jiangwu7/foresight/docs/competition/phase2_device/live_capture_galaxy_s23u.png

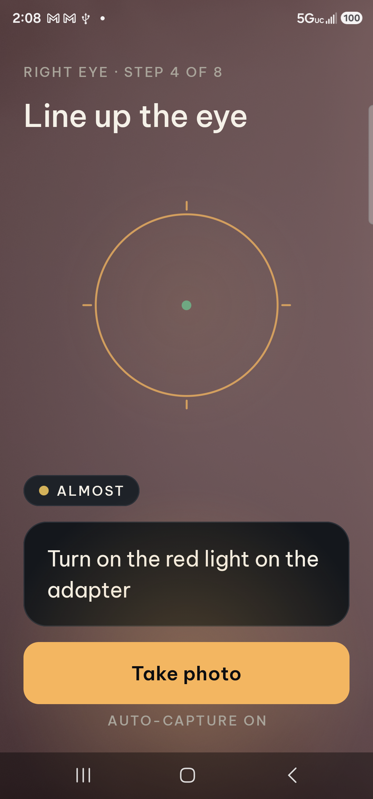
docs/competition/phase2_device/live_capture_galaxy_s23u.png
