jiangwu7/foresight/hardware/safety_calc.xlsx

Sheet: inputs
Input | Value | Status
f_eye_mm | 17 | standard
field_deg | 45 | standard
pupil_mm_worst | 8 | standard
T_polarizer | 0.38 | ASSUMED
R_beamsplitter | 0.5 | ASSUMED
T_lens | 0.92 | ASSUMED
f_collect | 0.1 | ASSUMED
f_pupil | 1 | standard
alignment_red.part | ASSUMED: 5 mm 660 nm AlGaInP LED, e.g. Kingbright WP7113SRC/J-type | ASSUMED
alignment_red.I_mA | 5 | ASSUMED
alignment_red.radiant_power_mW_at_20mA | 4 | ASSUMED
alignment_red.A_weight | 0.001 | ISO table
alignment_red.exposure_s | 120 | ASSUMED
capture_white.part | ASSUMED: 5 mm warm-white (2700-3000 K, CRI>=90) LED | ASSUMED
capture_white.I_mA | 20 | ASSUMED
capture_white.radiant_power_mW_at_20mA | 15 | ASSUMED
capture_white.A_weight | 0.2 | ASSUMED
capture_white.exposure_s | 0.05 | ASSUMED
capture_white.flashes_per_participant | 6 | ASSUMED
limit.E_AR_mW_cm2 | 2.2 | ISO 15004-2 Group 1 (verify)
limit.E_VIRR_W_cm2 | 0.7 | ISO 15004-2 Group 1 (verify)
limit.H_AR_J_cm2_group2 | 10 | ISO 15004-2 Group 1 (verify)

Sheet: results
Source | P_led (mW) | P_pupil (mW) | E_VIR-R (W/cm2) | margin | E_A-R (mW/cm2) | margin | exposure (s) | H_A-R (J/cm2) | Group 1?
alignment_red | 1 | 0.01748 | 1.122134936e-05 | 62381.08964 | 1.122134936e-05 | 196054.8531 | 120 | 1.346561923e-06 | yes
capture_white | 15 | 0.2622 | 0.0001683202403 | 4158.739309 | 0.03366404807 | 65.35161771 | 0.3 | 1.009921442e-05 | yes
retinal patch diameter (mm) | 14.08326112
retinal area (cm2) | 1.557744924
optical chain transmission | 0.01748
