jiangwu7/foresight/docs/README.md

# docs/

| File | Phase | Status |
|---|---|---|
| `consent_en.md`, `consent_es.md`, `consent_vi.md` | 3 | not started; must include "A photo of your retina is unique to you, like a fingerprint." and be reviewed by the district (§6) |
| `screener_training.md` | 3 | not started; 1-page how-to for volunteers |
| `audio_manifest.csv` | 4 | generated from string resources (§13.8) |
| `competition/` | 4 | metrics snapshots and figures for the SFT application |

Key dates (spec §10): application due **Nov 23, 2026**; semifinalists **Jan 20, 2027**; national finalists
**Mar 18, 2027**; final event **April 2027**.
