jiangwu7/foresight/assets/brand/concepts/round2/contact_round2_ideogram.jpg

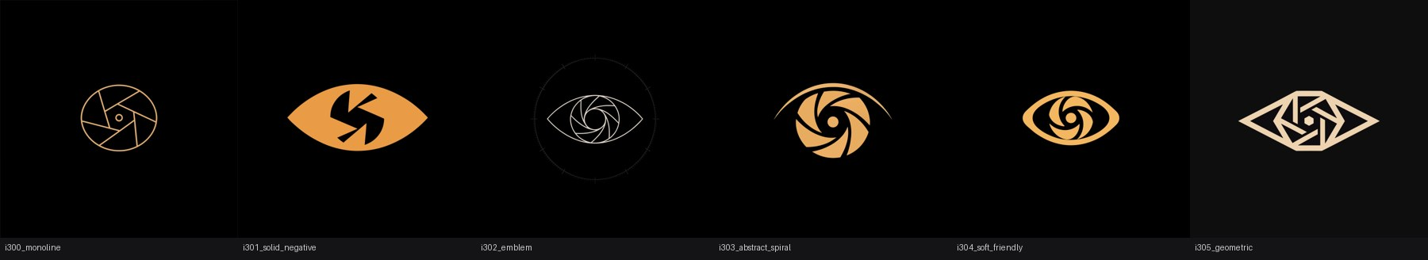
assets/brand/concepts/round2/contact_round2_ideogram.jpg
