jiangwu7/foresight/assets/brand/concepts/round2/contact_round2_recraft_gpt.jpg

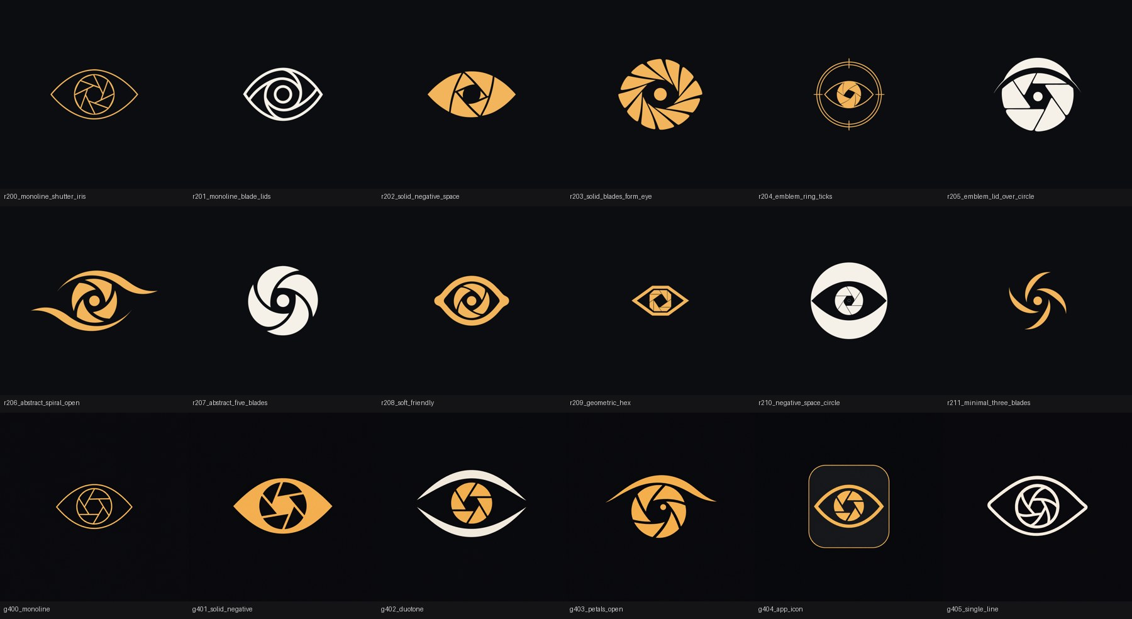
assets/brand/concepts/round2/contact_round2_recraft_gpt.jpg
