jiangwu7/foresight/assets/brand/concepts/round2/gpt/g400_monoline.png

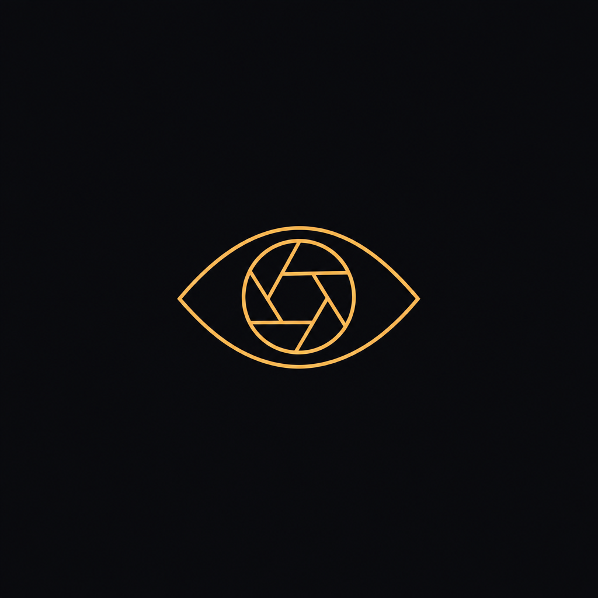
assets/brand/concepts/round2/gpt/g400_monoline.png
