jiangwu7/foresight/assets/brand/concepts/round2/gpt/g401_solid_negative.png

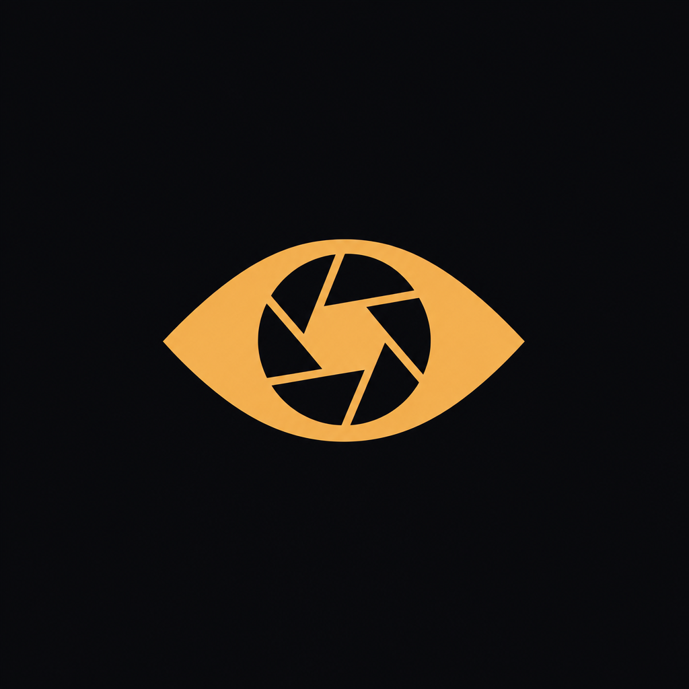
assets/brand/concepts/round2/gpt/g401_solid_negative.png
