jiangwu7/foresight/assets/brand/concepts/round2/gpt/g402_duotone.png

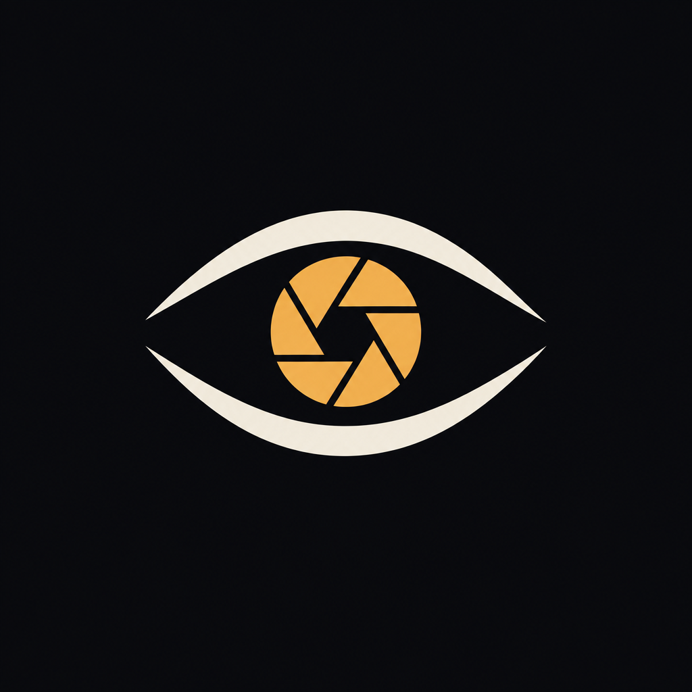
assets/brand/concepts/round2/gpt/g402_duotone.png
