jiangwu7/foresight/assets/brand/concepts/round2/gpt/g403_petals_open.png

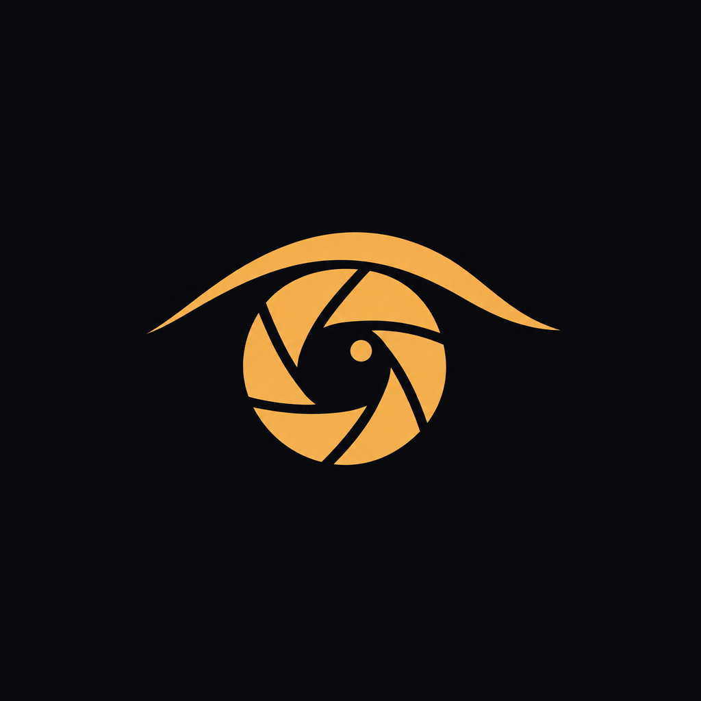
assets/brand/concepts/round2/gpt/g403_petals_open.png
