jiangwu7/foresight/assets/brand/concepts/round3/contact_round3.jpg

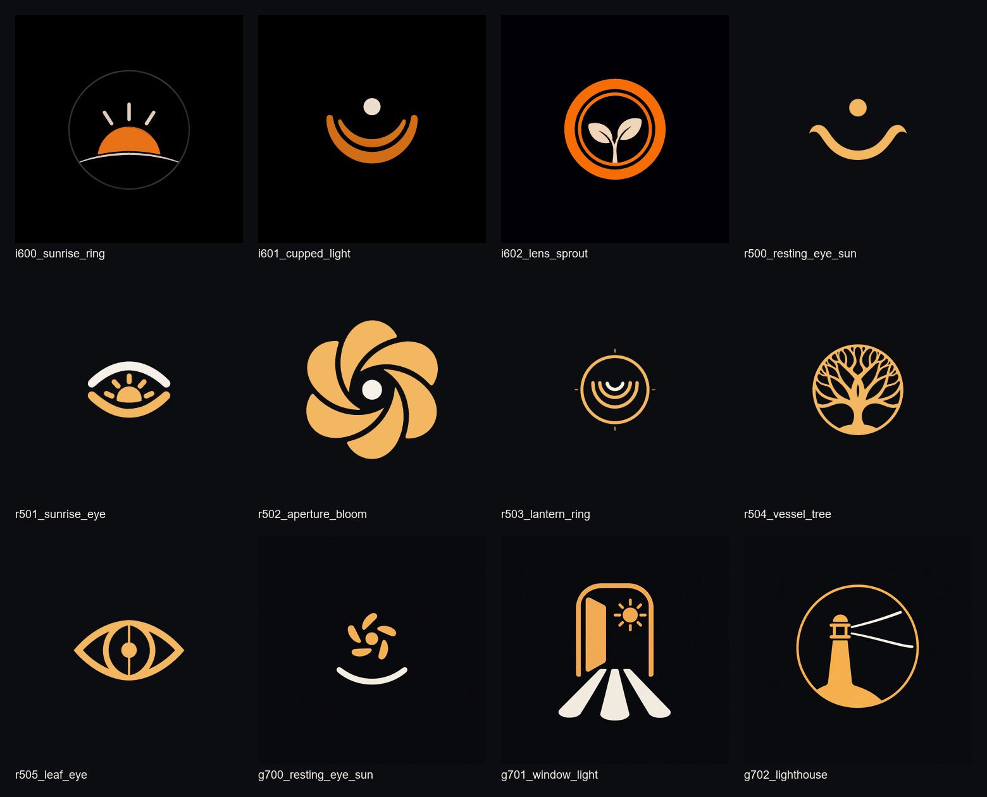
assets/brand/concepts/round3/contact_round3.jpg
