jiangwu7/foresight/assets/brand/concepts/round3/gpt/g700_resting_eye_sun.png

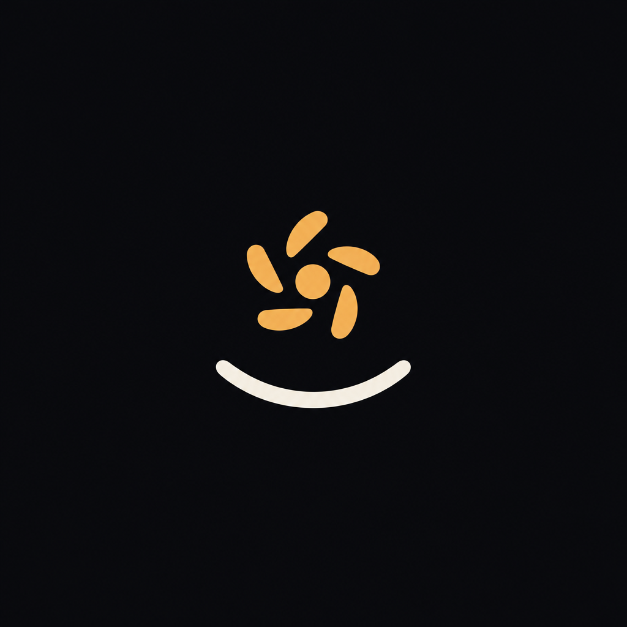
assets/brand/concepts/round3/gpt/g700_resting_eye_sun.png
