jiangwu7/foresight/assets/brand/concepts/round3/gpt/g701_window_light.png

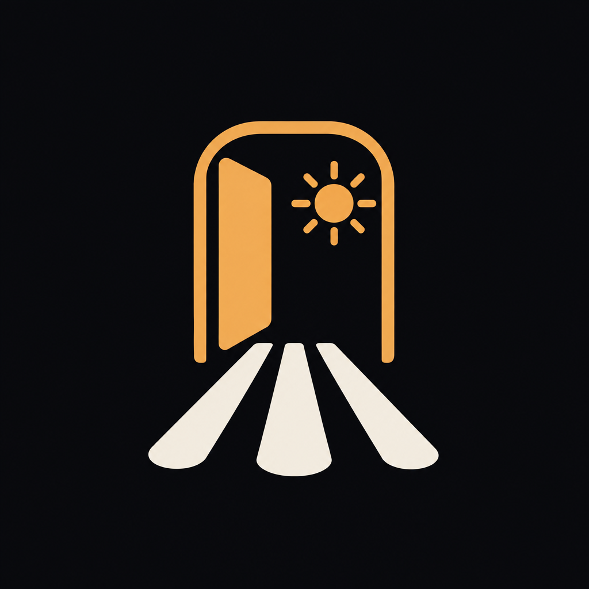
assets/brand/concepts/round3/gpt/g701_window_light.png
