jiangwu7/foresight/assets/brand/concepts/round3/gpt/g702_lighthouse.png

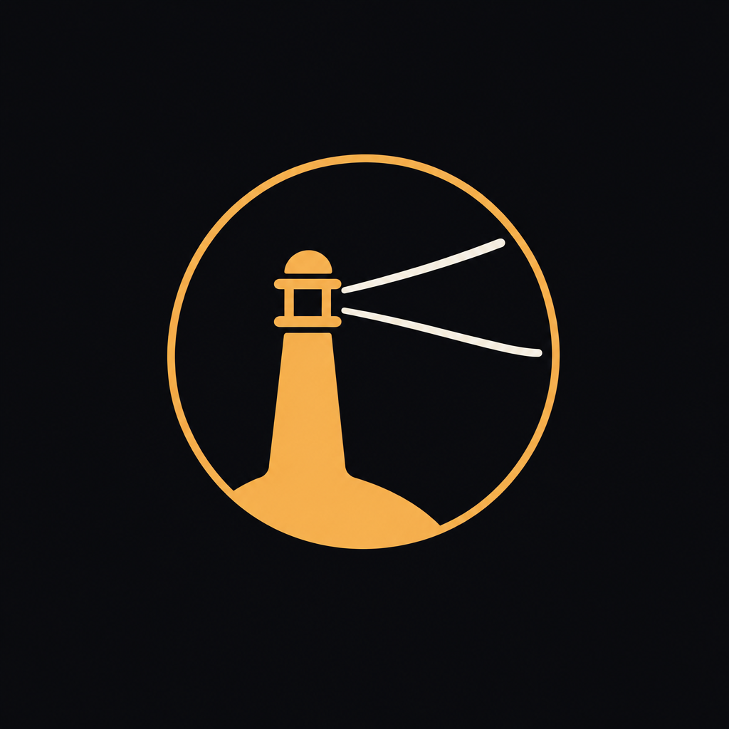
assets/brand/concepts/round3/gpt/g702_lighthouse.png
