jiangwu7/foresight/docs/competition/phase0_small_run_colab_t4/roc_curve.png

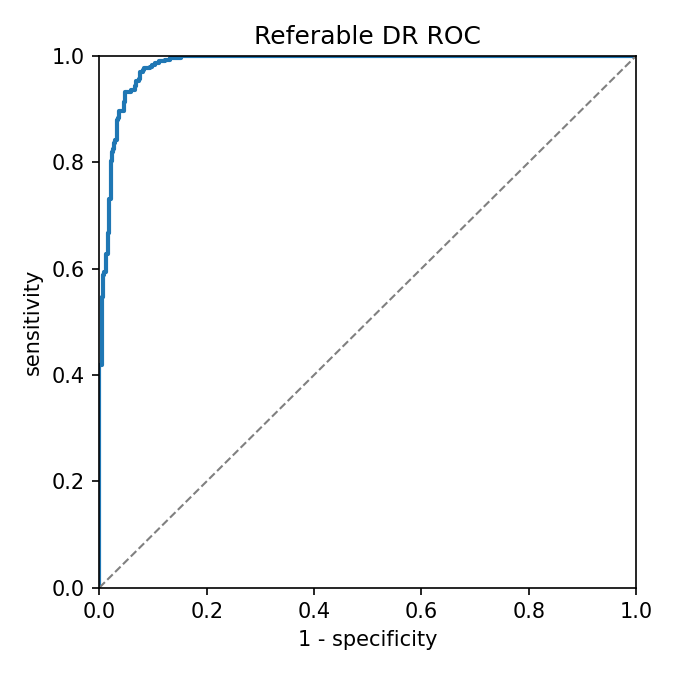
docs/competition/phase0_small_run_colab_t4/roc_curve.png
