jiangwu7/foresight/hardware/renders/exploded.png

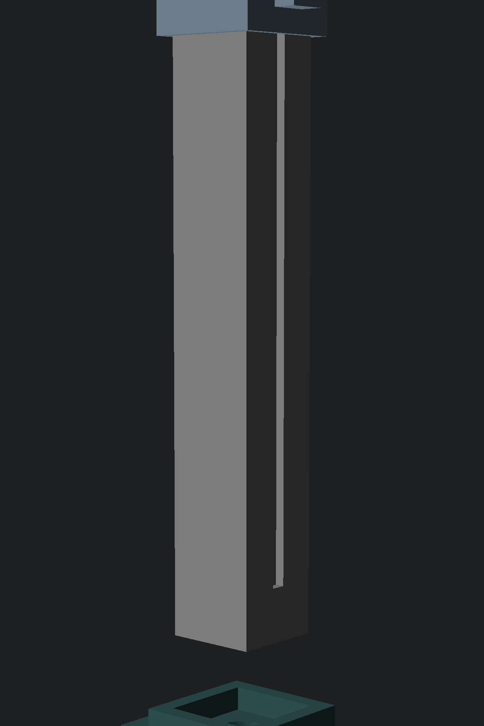
hardware/renders/exploded.png
