jiangwu7/foresight/hardware/renders/illumination.png

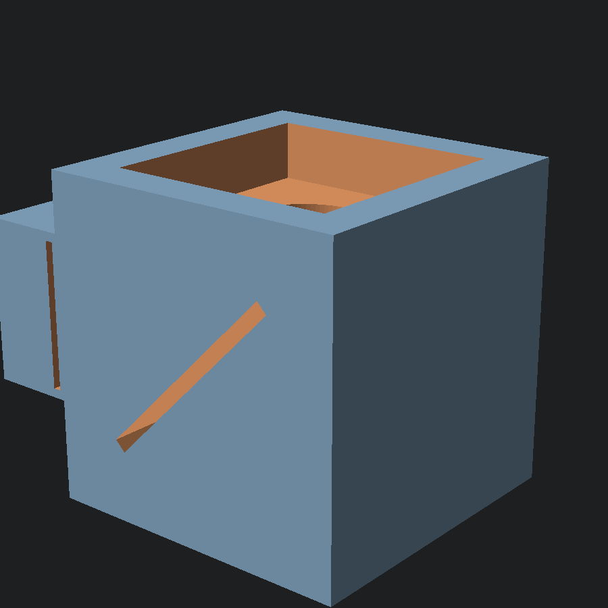
hardware/renders/illumination.png
