jiangwu7/foresight/hardware/stl/assembly.stl

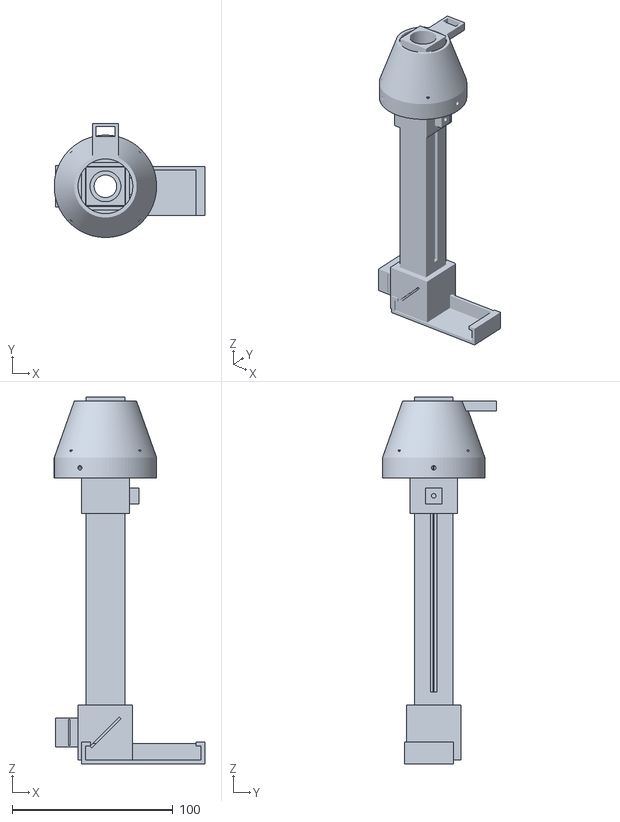
[picture p16: CAD file, 2026-11-04]
hardware/stl/assembly.stl
93.5 x 70.8 x 228.0
