jiangwu7/foresight/hardware/stl/rail.stl

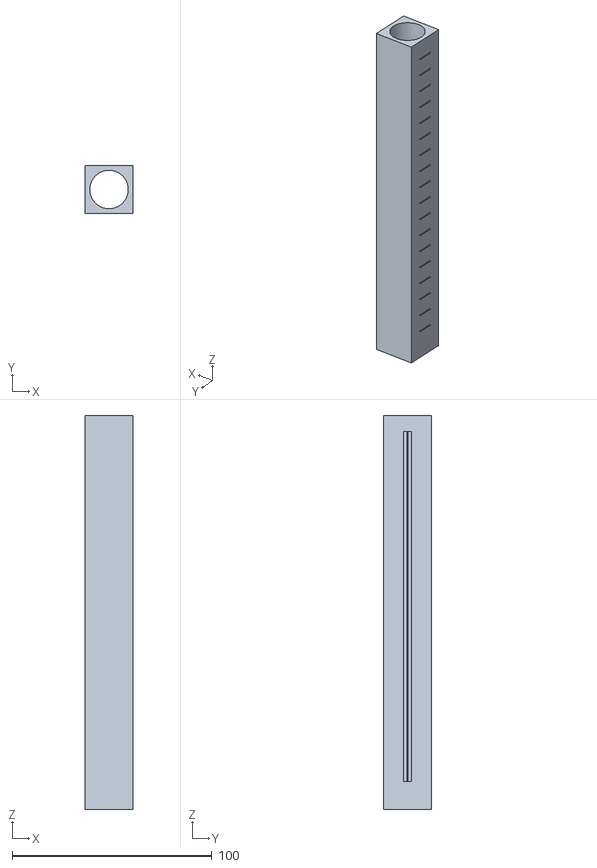
[picture p17: CAD file, 2026-11-04]
hardware/stl/rail.stl
24.0 x 24.0 x 197.3
