jiangwu7/foresight/hardware/stl/illumination.stl

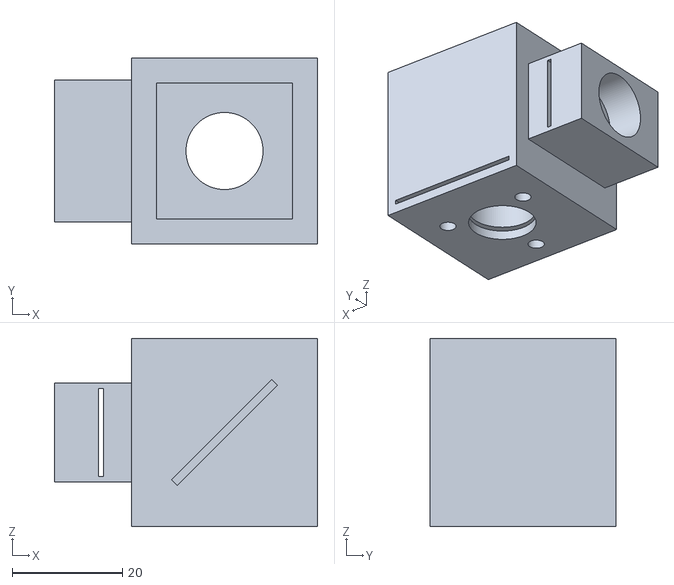
[picture p18: CAD file, 2026-11-04]
hardware/stl/illumination.stl
47.8 x 33.8 x 34.3
