jiangwu7/foresight/hardware/stl/carriage.stl

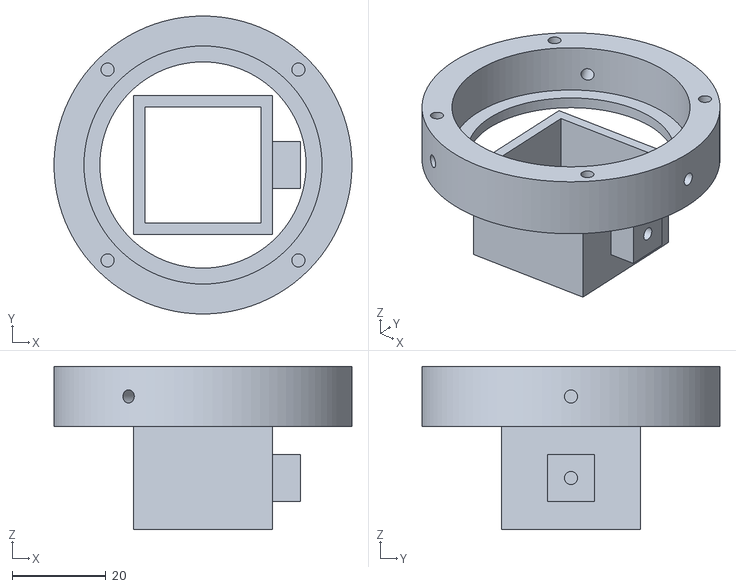
[picture p19: CAD file, 2026-11-04]
hardware/stl/carriage.stl
63.6 x 63.6 x 34.8
