jiangwu7/foresight/hardware/stl/clamp.stl

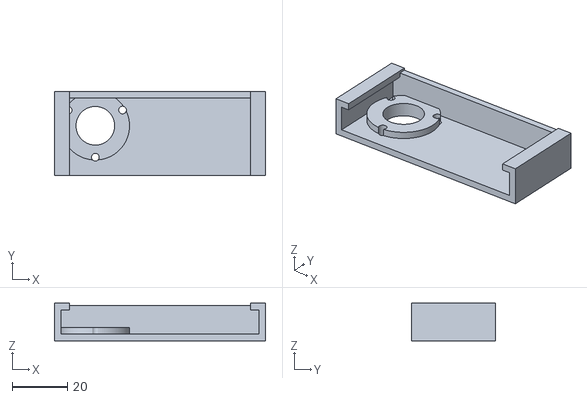
[picture p20: CAD file, 2026-11-04]
hardware/stl/clamp.stl
76.5 x 30.4 x 13.6
