jiangwu7/foresight/hardware/stl/eyecup.stl

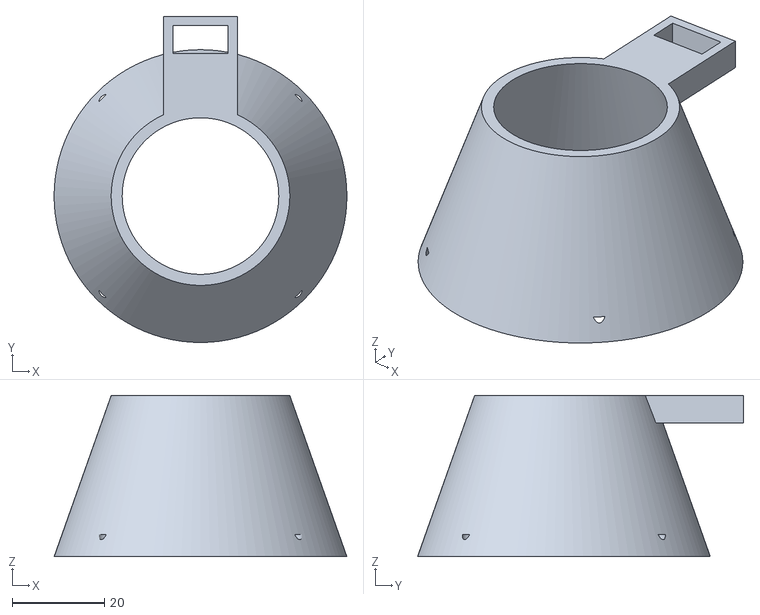
[picture p21: CAD file, 2026-11-04]
hardware/stl/eyecup.stl
63.6 x 70.8 x 35.0
