jiangwu7/foresight/(commit log)

2026-11-04 Phase 0: ML pipeline, Compose design system, CI, mood boards and logo concepts
    - ml/: preprocess.py (portable, Kotlin-port ready) with 14 unit tests; common.py,
    train_dr.py (--small / --smoke), eval.py (--check-card), export_tflite.py
    (ONNX always, TFLite where TensorFlow imports), make_model_card.py,
    make_fixtures.py, data/download.md
    - app/: Gradle project (AGP 8.7, Kotlin 2.0, Compose BOM 2024.12), ui/theme
    tokens (provisional) + GlowRing, InstrumentCard, BigAction, StatusPill,
    MetricReadout, LanguageTile, ResultCard, HeatmapOverlay; design-token lint
    and i18n completeness JVM tests; en/es/vi strings with strings_medical.xml;
    allowBackup=false + data extraction rules; debug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
    [adapter.scad]
2026-11-04 Direction A chosen; logo round 2 (eye x camera shutter, 24 marks, 3 models)
    - ASSETS.md: winning direction A style core and reference images; round-1
    logos rejected and archived under round1/; round-2 provenance (78 credits)
    and review notes
    - Color.kt tokens marked final for direction A
    - DECISIONS.md entry
2026-11-04 Logo chosen (round-2 i304); brand kit generated from the SVG
    - assets/brand/build_brand_kit.py: clean mark SVG/PNGs, lockups with the
    wordmark outlined from Be Vietnam Pro, Android adaptive + legacy launcher
    icons, dashboard favicon, palette.md with WCAG checks (all pass)
    - app: launcher icons wired in the manifest; accent token = mark's #F3B661
    - ASSETS.md provenance, DECISIONS.md entry, assets/brand/README.md
2026-11-04 APTOS on this machine: fixtures built, PowerShell-safe download docs
    - fixtures_manifest.json + expected/index.json pin the 25 real APTOS ids
    (images stay untracked per the dataset terms)
    - download.md/README: PowerShell has no && or unzip; use tar -xf
2026-11-04 Phase 1 core: Kotlin preprocessing port (bit-exact vs Python on 20 fixtures) and outcome mapping
    - ml/Preprocess.kt: pure-Kotlin port of preprocess.py (bbox, fused crop/pad/block-mean,
    bilinear, optional Ben Graham, normalize CHW/NHWC)
    - PreprocessEquivalenceTest: decodes fixtures with pngj, worst max-abs-diff 0.0 on 20 images
    - ml/Outcome.kt: draft §3.4 mapping (clinician review pending) + 9 exhaustive tests
2026-11-04 Phase 1 core: LiteRT runner + CAM heat map, encrypted Room/SQLCipher data layer, de-identified export, dashboard reader, quality heuristic
    - ml/: ModelCard parser, DrModelRunner (shape-matched outputs), ClassActivationMap,
    QualityHeuristic (dark/reflection/off-center/blurry, pinned on 41 fixtures)
    - data/: Entities per §3.6, DAOs incl. SQL-only de-id projection, KeyStoreCrypto
    (AES-GCM, Keystore), ForesightDatabase (SQLCipher), ImageStore (encrypted PNGs),
    DeidExport (+ disallowed-key validator), ScreeningRepository (analyze, delete
    my record, 30-day purge, deid JSON + password-protected clinic zip)
    - dashboard/: drag-and-drop reader with schema + personal-field rejection, summary c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
2026-11-04 Phase 1: full screening flow in Compose, trilingual strings, PDF referral card, settings, instrumented test
    - ui/: ForesightNav (spec §3.1 routes), ScreeningViewModel (session state), FlowScreen,
    screens for home/new event/language/consent/intake(6, under-18 refusal)/capture (photo
    import + gradability + retake ≤3)/processing/results (heat map, read-aloud, delete my
    record)/card (PDF + QR, print, share)/done/settings (model card, exports, purge)
    - i18n/: session-language context + TTS; strings in en/es/vi (ES/VI drafts), medical
    wording in strings_medical.xml per §3.4
    - theme/: OptionTile, CheckRow, paper tokens; drawables for the mark; FileProvider
    - androidTest: end-to-end flow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
2026-11-04 Phase 1: first device run — fix invisible text and capture-screen crash; e2e test passes on phone
    - ForesightTheme provides LocalContentColor = onBackground (text outside Surfaces was black on near-black)
    - Localized: ContextWrapper around the Activity instead of a bare configuration Context, so the photo
    picker, share sheet and PrintManager can find the Activity; owners re-provided explicitly
    - ScreeningFlowTest: wait for the event list, create an event if none, read the fixture via the
    instrumentation shell (scoped storage denies direct reads); keep APKs installed after connected tests
    - DECISIONS.md: first-device-run entry
2026-11-04 Replace broken TFLite model with a verified fp16 export; add export verification guards
    The shipped dr_m2_int8.tflite (onnx2tf 2.6.9 flatbuffer_direct) returned the same output for every
    image, so every participant was graded red on the first device run. Desktop LiteRT cannot even load it.
    - ml/verify_tflite.py: loads + input-dependence + agreement with ONNX on fixtures; export_tflite.py
    runs it on every file and renames failures *.BROKEN.tflite; no crash when all files are rejected
    - requirements-export.txt pinned to onnx2tf 1.x + TensorFlow <2.20; onnx2tf's own quantizer bypassed
    (writes its sample batch locally); int8 done by the official TFLite converter with calibration
    - ship mode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
2026-11-04 Phase 2 step 1: adapter v1 geometry, STLs, renders, safety draft, Mode A wiring, Mode B firmware, BOM
    - hardware/adapter.scad: full parametric model (clamp, illumination module, rail, carriage, eyecup),
    part= switch; Makefile exports stl/ and renders/ with OpenSCAD
    - SAFETY.md: draft ISO 15004-2 Group 1 calculation from safety_calc.py (xlsx/json), all inputs tagged
    ASSUMED, margins > 60x; still unsigned, no human subjects
    - wiring_mode_a.md: switch + 555 one-shot fixing the flash at ~40 ms; firmware/foresight_adapter.ino
    Mode B reference with caps in constants
    - bom.md: researched prices; honest totals (~$41 adapter + lens; used Volk 20D ~$210)
    - reference_rig.md: Z8 procedure; hardwar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
    [adapter.scad, assembly.stl, carriage.stl, clamp.stl, eyecup.stl, illumination.stl, rail.stl, safety_calc.xlsx]
2026-11-04 Phase 2 step 2: live capture — CameraX manual controls, dim-red mode, auto-capture, Mode A prompts
    - capture/: CameraController (AF/AE off, focus from Settings, two exposure programs, AWB lock, ~5 fps
    analysis, still capture), AutoCapture state machine (+4 JVM tests), AdapterLink Mode A/B, CaptureSettings
    - LiveCaptureScreen with GlowRing + fixation dot, traffic-light quality, prompts, haptic/spoken cues,
    manual shutter; EyeReviewBlock shared with the import flow; Nav routes to it unless import mode / test hook
    - Settings → Camera: calibration, adapter mode, import switch, device check, LED test text
    - strings EN/ES/VI; CAMERA permission only; QualityAssessor interface for M1
    - andro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
2026-11-04 androidTest: case-insensitive text matching (pills render small caps); LiveCaptureTest passes on the Galaxy
2026-11-04 Live capture verified on the Galaxy; Mode A flash catching; rail moved out for 100 mm closest focus
    - FlashCatcher (pure, 5 tests): keeps the frame where the screener's flash appears during a 4 s window;
    CameraController.catchFlash at full frame rate, 1280x960 analysis stream; LiveCaptureScreen uses it in
    Mode A with a plain still as fallback; defaults focus 100 mm / capture 33 ms ISO 200
    - Settings device check shows the closest focus distance (EN/ES/VI string)
    - adapter.scad: rail_min_gap 140 / travel 80 (lens 140-220 mm) for phones that focus no closer than 100 mm;
    STLs + renders regenerated; README explains how to set it from the device check
    - LiveCameraDiagnosticTest: binds the r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
    [adapter.scad, assembly.stl, rail.stl]
2026-11-04 Trim the participant flow per user tests: consent age gate, no intake by default, follow-up on results
    - Default flow: language → consent → capture; the six intake questions run only when the new Settings
    switch "Ask the optional intake questions" is on
    - Consent: required "I am 18 or older" checkbox + "The participant is under 18" link to the refusal screen
    - Results: "For the clinic (optional)" card with phone number and share-with-clinic consent, saved on
    leaving; step labels adapt (7 or 8 steps); strings EN/ES/VI; flow drivers updated
    - DECISIONS.md: deviation from spec §3.3 recorded as the team lead's decision
